valorekhov/Buratino-Hardware/buratino bom.xlsx

PN | Value | Name | Device | Package | Parts | Qty
MCU
ATmega256RFR2-ZU | ATMEGA256RFR2 |  | ATMEGA128RFA1 | QFN-64 | U4 | 1
Tellurian 3960A 16MHz | 16MHz | Crystals | CRYSTALABM10 | CRYSTAL-SMD-2.5X2-ABM10 | X1 | 1
Tellurian 3960B 32.768k | 32.768k | Crystals | CRYSTAL-NOGND | CRYSTAL-SMD-2X1.2-ABS06 | X2 | 1
RF
2450BM15A0015E | BALUN | Atmega256RFR2 Balun | BALUN0805 | BALUN | B1 | 1
2450AT43A100E | ANTENNA2SMD5 | Atmega256RFR2 Antenna | ANTENNA2SMD5 | ANTENNA-CHIP5 | Y1 | 1
LQG15HS4N7S02D | 4.7nH | Inductor | INDUCTOR | 0402- | L2 | 1
Power - Battery, Ext Power
TPS78222 | 2.2v | Voltage Regulator LDO, 2.2v | LDO-TPS78233 | SOT23-5 | U2 | 1
AYZ0102AGRLC | SPST | SPST Switch | SWITCH-SPSTSMD2 | SWITCH-SPDT-SMD | S2 | 1
SIP32431DNP3-T1GE4TR-ND | SWITCH |  | SWITCH-MOSFETTDFN4 | TDFN4 | U7 | 1
LTC3105EMS#PBF | LTC3105MS | PV setup up converter | LTC3105MS | MSOP12 | IC1 | 1
2n7002PW |  | Pull down, enable control for LTC3105 | MOSFET-NCHANNEL2N7002PW | SOT323 | Q2 | 1
NR6045T100M | 10uH | Inductor for LTC3105 | NR6045T100M | NR2 | L1 | 1
EEC-RG0V105H | 1F | Optional super cap in the PV mode | EEC-RG0V105H | SCAP1 | CSTOR | 1
Sensors
SI7021-A10-GM1R |  | Temp & Humidity sensor (GM1R includes cover) | SI7021A10 | DFN6-3X3 | SI7021 | 1
TSL2561 |  | LUX sensor | TSL2561DFN | DFN6-2X2 | TSL2561 | 1
IRS-B210ST01R1 |  | PIR sensor | IRS-B210ST01R1 | PIRSMT | PIR | 1
Misc
C1005C0G1H010C | 1.0pF | Capacitor | CAP0402-CAP | 0402-CAP | C9, C23 | 2
C1005C0G1H100D050BA | 10pF | Loader Caps for Crystals | CAP0402-CAP | 0402-CAP | C12, C13, C14, C15 | 4
C1608NP01H220J080AA | 22pF | Capacitor | CAP0603-CAP | 0603-CAP | CFF | 1
C1608X8R1E104K080AA | 0.1uF | Capacitor | CAP0603-CAP | 0603-CAP | C3, C16 | 2
C1608X7R1A105M080AC | 1.0uF | Capacitor | CAP0603-CAP | 0603-CAP | CAUX, COUT, COUT1, C7, C8 | 5
C1608X7S1A225K080AC | 2.2uF | Capacitor | CAP0603-CAP | 0603-CAP | C11 | 1
C1608X7S1A475K080AC | 4.7uF | Capacitor | CAP0603-CAP | 0603-CAP | CLDO | 1
C2012X7R1A106K125AC | 10uF | Capacitor | CAP0805-CAP | 0805-CAP | CIN | 1
ERJ-2GE0R00X | 0 Ohm | 0 Ohm Resistor | RESISTOR0402-RES | 0402-RES | R24 | 1
ERJ-3GEYJ471V | 470 Ohm | Resistor | RESISTOR0603-RES | 0603-RES | R11, R12, R18 | 3
ERJ-3GEYJ202V | 2K | Resistor | RESISTOR0603-RES | 0603-RES | R22, R23 | 2
ERJ-3GEYJ103V | 10K | Resistor | RESISTOR0603-RES | 0603-RES | R3 | 1
ERJ-3EKF3012V | 30.1K | Resistor | RESISTOR0603-RES | 0603-RES | RMPPC | 1
ERJ-3GEYJ473V | 47K | Resistor | RESISTOR0603-RES | 0603-RES | R4 | 1
ERJ-3GEYJ104V | 100k | Resistor | RESISTOR0603-RES | 0603-RES | R5 | 1
ERJ-3EKF6043V | 604K | Resistor | RESISTOR0603-RES | 0603-RES | R2 | 1
ERJ-3EKF1374V | 1.37M | Resistor | RESISTOR0603-RES | 0603-RES | R1 | 1
 | BTN | Momentary Switch | TAC_SWITCHPTH | TACTILE-PTH | S1 | 1
CLVBA-FKA-CAEDH8BBB7A363 or CLV1A-FKB-CJ1M1F1BB7R4S3CT-ND | LED-RGB | LED-Bicolor Red/Green | LED-RGBPLCC4 | PLCC4 | U8 | 1
TS-132-G-A | M16PTH |  | M16PTH | 1X16 | JP-L, JP-R | 1
SM02B-SFHRS-TF(LF)(SN) | SMT power header |  | M02JST-SFH | JST-SFH | BATT, VIN1 | 2
