valorekhov/Buratino-Hardware/eagle/buratino.brd

## EAGLE design eagle/buratino.brd (2014-09-02)

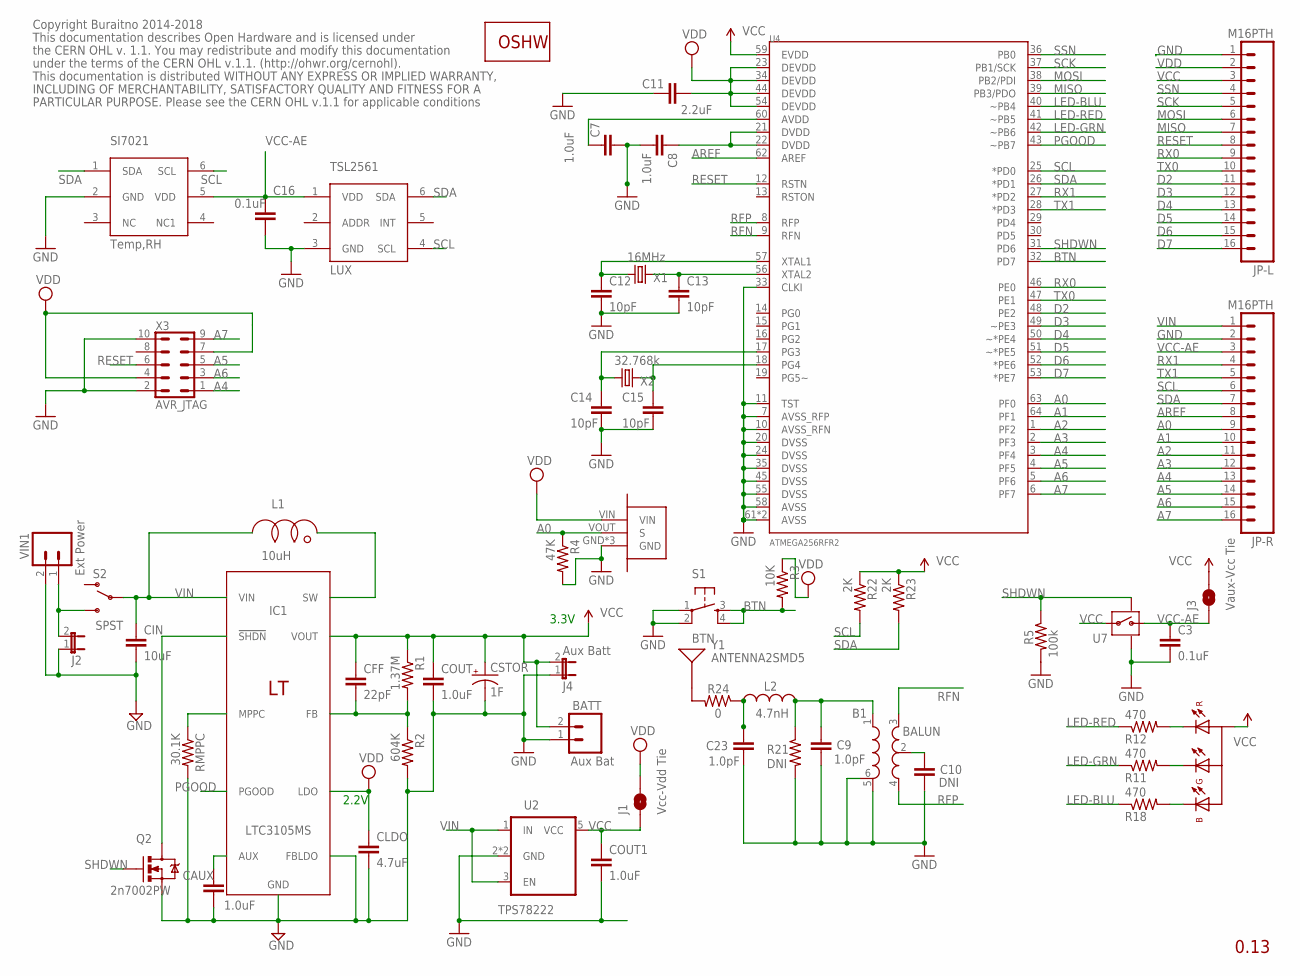
[picture p1: schematic buratino.sch]

Parts:
B1: BALUN
BATT: Aux Bat; JST-SFH
C3, C16: 0.1uF; 0603-CAP
C7, C8: 1.0uF; 0603-CAP
C9, C23: 1.0pF; 0402-CAP
C10: DNI; 0402-CAP
C11: 2.2uF; 0603-CAP
C12, C13, C14, C15: 10pF; 0402-CAP
CAUX: 1.0uF; 0603-CAP
CFF: 22pF; 0603-CAP
CIN: 10uF; 0805
CLDO: 4.7uF; 0603-CAP
COUT, COUT1: 1.0uF; 0603-CAP
CSTOR: 1F; SCAP1
IC1: LTC3105MS; MSOP12
J1: Vcc-Vdd Tie; SJ_2S-NO
J2: Ext Battery; 1X02
J3: Vaux-Vcc Tie; SJ_2S-NO
J4: Aux Batt; 1X02
JP-L: M16PTH; 1X16
JP-R: M16PTH; 1X16
L1: 10uH; NR2
L2: 4.7nH; 0402-CAP
PIR: IRS-B210ST01R1; PIRSMT
Q2: 2n7002PW; SOT323
R1: 1.37M; 0603-RES
R2: 604K; 0603-RES
R3: 10K; 0603-RES
R4: 47K; 0603-RES
R5: 100k; 0603-RES
R11, R12, R18: 470; 0603-RES
R21: DNI; 0402-RES
R22, R23: 2K; 0603-RES
R24: 0; 0402-RES
RMPPC: 30.1K; 0603-RES
S1: BTN; TACTILE-PTH
S2: SPST; SWITCH-SPDT-SMD
SI7021: Temp,RH; DFN6-3X3
TSL2561: LUX; DFN6-2X2
U2: TPS78222; SOT23-5
U4: ATMEGA256RFR2; QFN-64
U7: SWITCH; TDFN4
U8: LED-RGB; PLCC4
U$2: LOGO-OSHWSILKSCREEN; LOGO-OSHW-SS
VIN1: Ext Power; JST-SFH
X1: 16MHz; CRYSTAL-SMD-2.5X2-ABM10
X2: 32.768k; CRYSTAL-SMD-2X1.2-ABS06
X3: AVR_JTAG; PHB_1MM27_2X05_SNS
Y1: ANTENNA2SMD5; ANTENNA-CHIP5

Connections:
A0: JP-R.9, PIR.VOUT (S), R4.1, U4.63 (PF0)
A1: JP-R.10, U4.64 (PF1)
A2: JP-R.11, U4.1 (PF2)
A3: JP-R.12, U4.2 (PF3)
A4: JP-R.13, U4.3 (PF4), X3.1
A5: JP-R.14, U4.4 (PF5), X3.5
A6: JP-R.15, U4.5 (PF6), X3.3
A7: JP-R.16, U4.6 (PF7), X3.9
AREF: JP-R.8, U4.62 (AREF)
BTN: R3.2, S1.3, S1.4, U4.32 (PD7)
D2: JP-L.11, U4.48 (PE2)
D3: JP-L.12, U4.49 (~PE3)
D4: JP-L.13, U4.50 (~*PE4)
D5: JP-L.14, U4.51 (~*PE5)
D6: JP-L.15, U4.52 (*PE6)
D7: JP-L.16, U4.53 (*PE7)
GND: B1.5 (GND), B1.6 (GND), BATT.1, C3.2, C7.2, C8.2, C9.2, C10.2, C11.2, C12.2, C13.2, C14.2, C15.2, C16.2, C23.2, CAUX.2, CIN.2, CLDO.2, COUT.2, COUT1.2, CSTOR.2 (-), IC1.3 (FBLDO), IC1.6 (GND), IC1.7 (GND), J2.1, J4.1, JP-L.1, JP-R.2, PIR.GND, PIR.GND*1 (GND), PIR.GND*2 (GND), Q2.2 (S), R2.2, R4.2, R5.2, R21.2, RMPPC.2, S1.1, S1.2, SI7021.2 (GND), TSL2561.3 (GND), U2.2 (GND), U2.4 (GND), U4.7 (AVSS_RFP), U4.10 (AVSS_RFN), U4.11 (TST), U4.20 (DVSS), U4.24 (DVSS), U4.33 (CLKI), U4.35 (DVSS), U4.45 (DVSS), U4.55 (DVSS), U4.58 (AVSS), U4.61 (AVSS), U4.PADDLE (AVSS), U7.P$2 (GND), U7.P$5 (GND), VIN1.2, X1.P$2 (GND), X1.P$4 (GND), X3.2, X3.10
LED-BLU: R18.1, U4.40 (~PB4)
LED-GRN: R11.1, U4.42 (~PB6)
LED-RED: R12.1, U4.41 (~PB5)
MISO: JP-L.7, U4.39 (PB3/PDO)
MOSI: JP-L.6, U4.38 (PB2/PDI)
unnamed: R12.2, U8.P$1 (R-C)
unnamed: C23.1, L2.2, R24.1
unnamed: B1.1 (IN), C9.1, L2.1, R21.1
unnamed: R11.2, U8.P$4 (G-C)
unnamed: R18.2, U8.P$3 (B-C)
unnamed: C7.1, U4.60 (AVDD)
unnamed: IC1.9 (SW), L1.P$2 (B)
unnamed: B1.2 (RFGND), C10.1
unnamed: CAUX.1, IC1.12 (AUX)
unnamed: C12.1, U4.57 (XTAL1), X1.P$1 (1)
unnamed: C13.1, U4.56 (XTAL2), X1.P$3 (2)
unnamed: C14.1, U4.17 (PG3), X2.P$1 (1)
unnamed: C15.1, U4.18 (PG4), X2.P$2 (2)
unnamed: CFF.2, IC1.1 (FB), R1.2, R2.1
unnamed: C8.1, U4.21 (DVDD), U4.22 (DVDD)
unnamed: IC1.4 (!SHDN), Q2.3 (D)
unnamed: IC1.5 (MPPC), RMPPC.1
unnamed: J2.2, S2.3 (S), VIN1.1
unnamed: R24.2, Y1.FEED
PGOOD: IC1.10 (PGOOD), U4.43 (~PB7)
RESET: JP-L.8, U4.12 (RSTN), X3.6
RFN: B1.3 (OUT1), U4.9 (RFN)
RFP: B1.4 (OUT2), U4.8 (RFP)
RX0: JP-L.9, U4.46 (PE0)
RX1: JP-R.4, U4.27 (*PD2)
SCK: JP-L.5, U4.37 (PB1/SCK)
SCL: JP-R.6, R22.2, SI7021.6 (SCL), TSL2561.4 (SCL), U4.25 (*PD0)
SDA: JP-R.7, R23.2, SI7021.1 (SDA), TSL2561.6 (SDA), U4.26 (*PD1)
SHDWN: Q2.1 (G), R5.1, U4.31 (PD6), U7.P$4 (ON)
SSN: JP-L.4, U4.36 (PB0)
TX0: JP-L.10, U4.47 (PE1)
TX1: JP-R.5, U4.28 (*PD3)
VCC: BATT.2, CFF.1, COUT.1, COUT1.1, CSTOR.1 (+), IC1.11 (VOUT), J1.1, J3.2, J4.2, JP-L.3, R1.1, R22.1, R23.1, U2.5 (VCC), U4.59 (EVDD), U7.P$3 (IN), U8.P$2 (A)
VCC-AE: C3.1, C16.1, J3.1, JP-R.3, SI7021.5 (VDD), TSL2561.1 (VDD), U7.P$1 (OUT)
VDD: C11.1, CLDO.1, IC1.2 (LDO), J1.2, JP-L.2, PIR.VIN, R3.1, U4.23 (DEVDD), U4.34 (DEVDD), U4.44 (DEVDD), U4.54 (DEVDD), X3.4, X3.7
VIN: CIN.1, IC1.8 (VIN), JP-R.1, L1.P$1 (A), S2.2, U2.1 (IN), U2.3 (EN)

Notes on the sheet:
0.13
Copyright Buraitno 2014-2018
This documentation describes Open Hardware and is licensed under
the CERN OHL v. 1.1. You may redistribute and modify this documentation
under the terms of the CERN OHL v.1.1. (http://ohwr.org/cernohl).
This documentation is distributed WITHOUT ANY EXPRESS OR IMPLIED WARRANTY,
INCLUDING OF MERCHANTABILITY, SATISFACTORY QUALITY AND FITNESS FOR A
PARTICULAR PURPOSE. Please see the CERN OHL v.1.1 for applicable conditions
2.2V
3.3V

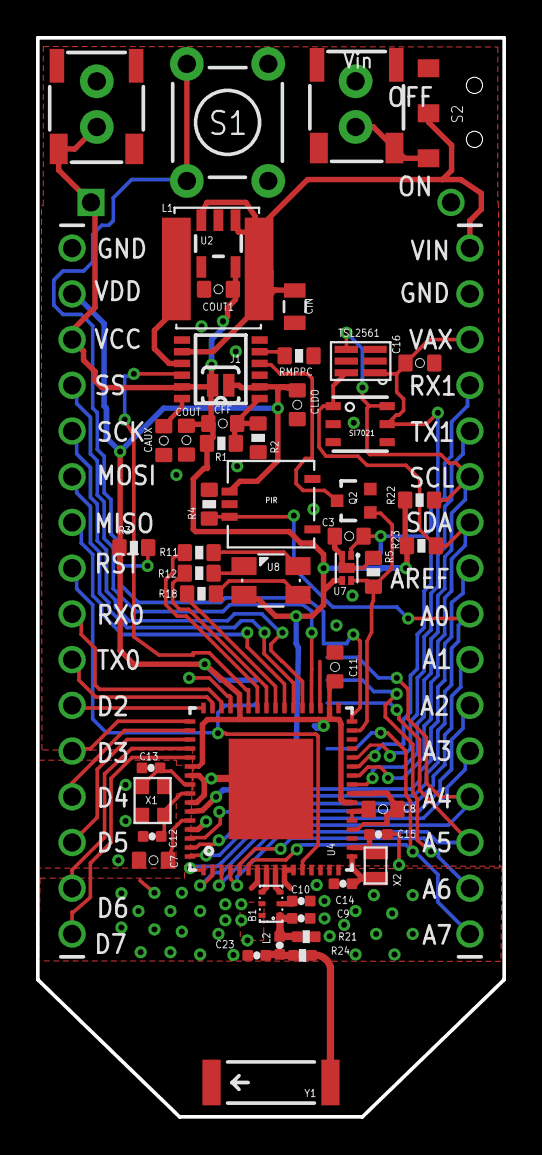
[picture p2: board buratino.brd from above]

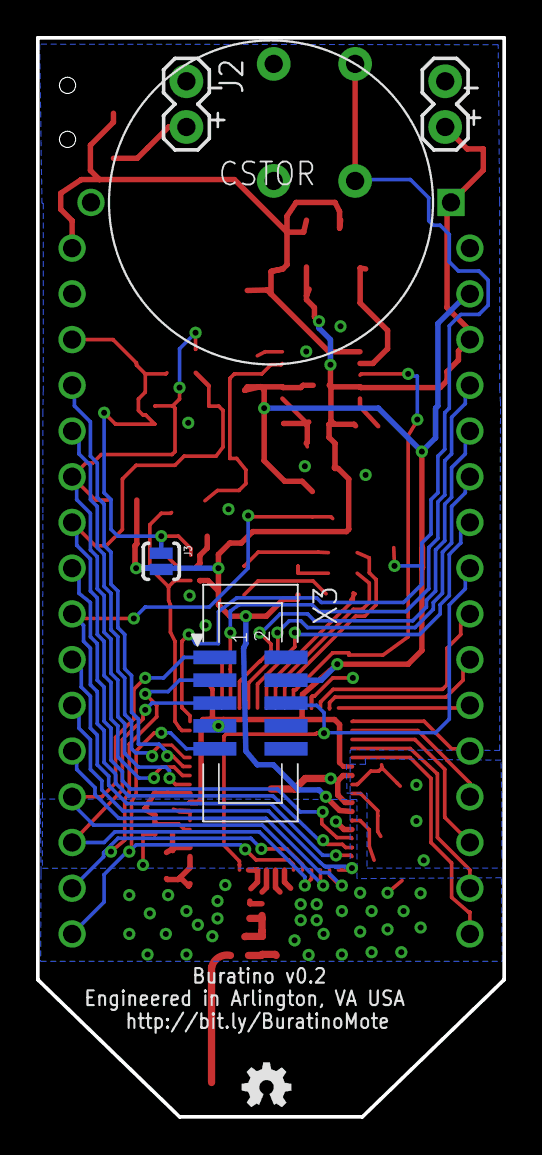
[picture p3: board buratino.brd from below]

Board: 2 copper layers, 25.9 x 59.9 mm, 59 parts (6 on the bottom side), 58 nets.
