valorekhov/Buratino-Hardware/(commit log)

2014-08-29 replace ICSP with JTAG
    [buratino.brd, buratino.sch]
2014-08-30 replace 2mm headers with 0.1" headers
    [buratino.brd, buratino.sch]
2014-09-01 add PIR
    [buratino.brd, buratino.sch]
2014-09-02 add BOM, final tweaks
    [buratino bom.xlsx, buratino.brd, buratino.sch]
