valorekhov/Buratino-Hardware/(notices)

Notices in the files:
eagle/buratino.brd:
Licensed under CERN OHL v.1.1
parts and their libraries:
SparkFun-DiscreteSemi: Licensing: Creative Commons ShareAlike 4.0 International - https://creativecommons.org/licenses/by-sa/4.0
